samjacoby/touchsynth/README.md

# Touch Synth
32U4-based Arduino (Leonardo) compatible synthesizer board

In effect, "forked" from bdm.cc
