samjacoby/touchsynth/board/touchsynth.brd

## EAGLE design board/touchsynth.brd (2013-03-25)

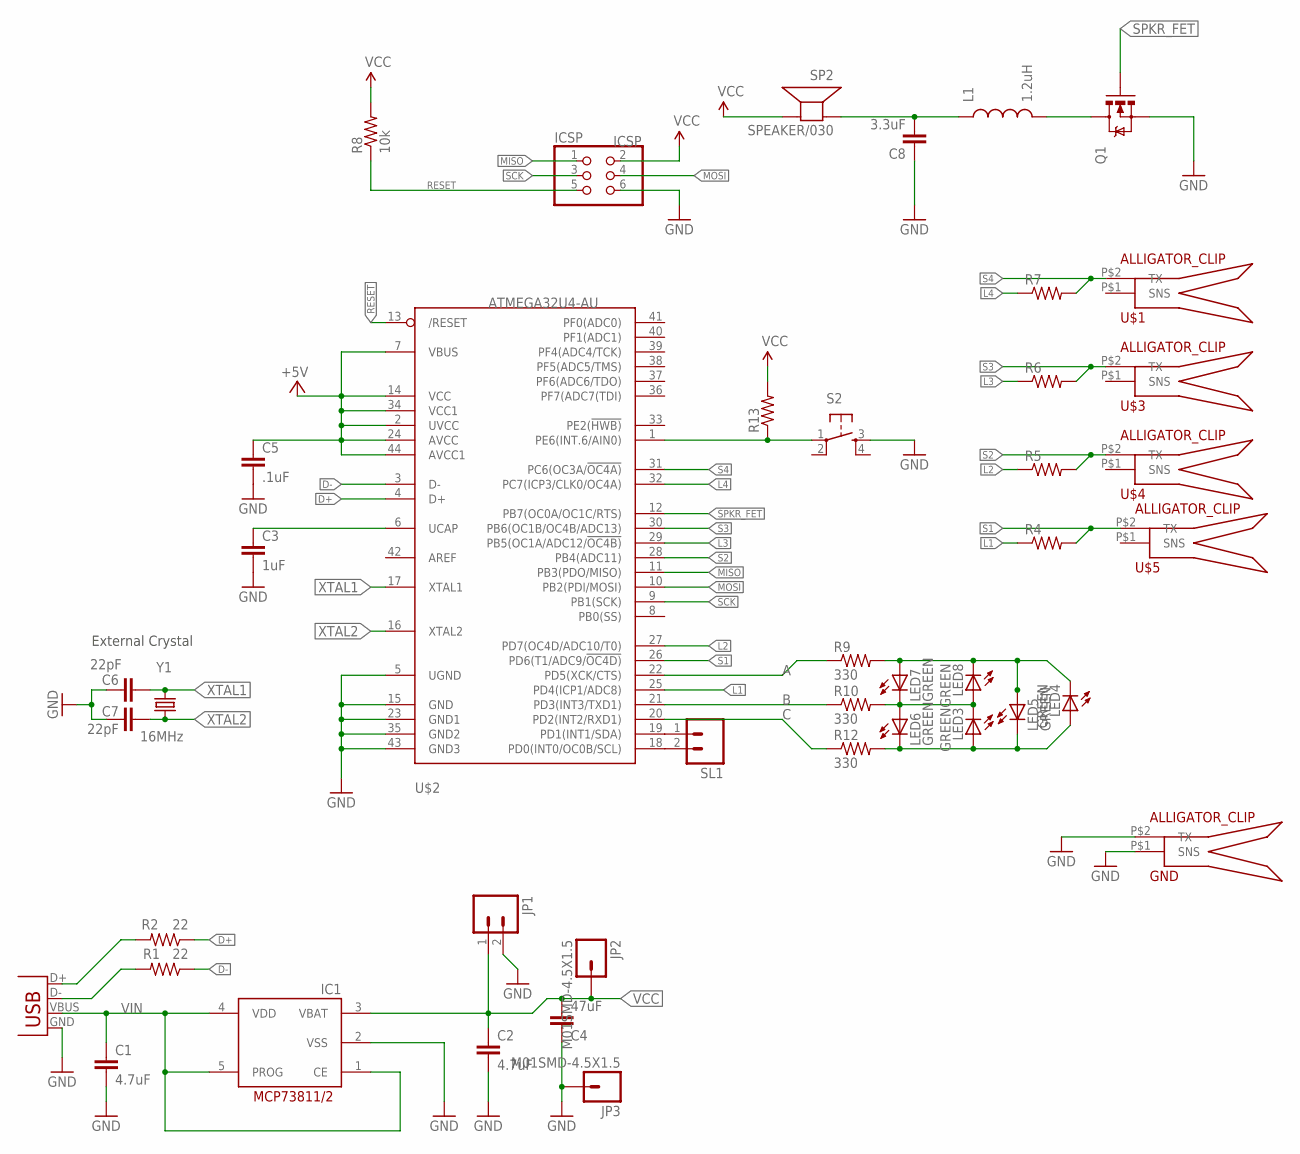
[picture p1: schematic touchsynth.sch]

Parts:
C1, C2: 4.7uF; 0603-CAP
C3: 1uF; 0603-CAP
C4: 47uF; 1206
C5: .1uF; 0603-CAP
C6, C7: 22pF; 0402-CAP
C8: 3.3uF; 0603-CAP
GND: ALLIGATOR_CLIP
IC1: MCP73811/2; SOT23-5L
ICSP: ICSP; 2X03
JP1: M02PTH; 1X02
JP2, JP3: M01SMD-4.5X1.5; PAD-1.5X4.5
L1: 1.2uH; 1210
LED3, LED4, LED5, LED6, LED7, LED8: GREEN; LED-1206-BOTTOM
Q1: MOSFET-NCHANNELSMD; SOT23-3
R1, R2: 22; 0402-RES
R4, R5, R6, R7, R13: RESISTOR0603-RES; 0603-RES
R8: 10k; 0603-RES
R9, R10, R12: 330; 0603-RES
S2: TAC_SWITCHSMD; TACTILE_SWITCH_SMD
SL1: M02; 02P
SP2: SPEAKER/030; AST-030
U$1, U$3, U$4, U$5: ALLIGATOR_CLIP
U$2: ATMEGA32U4-AU; TQFP44-THIN
X1: USB; USB-MINIB-NOSTOP-THIN
Y1: 16MHz; CRYSTAL-SMD-5X3

Connections:
A: R9.1, U$2.22 (PD5(XCK/CTS))
B: R10.1, U$2.21 (PD3(INT3/TXD1))
C: R12.1, U$2.20 (PD2(INT2/RXD1))
D+: R2.1, U$2.4 (D+)
D-: R1.1, U$2.3 (D-)
GND: C1.2, C2.2, C3.2, C4.1, C5.2, C6.2, C7.2, C8.1, GND.P$1 (SNS), GND.P$2 (TX), IC1.2 (VSS), ICSP.6, JP1.2, JP3.P$1, Q1.2 (S), S2.3, U$2.5 (UGND), U$2.15 (GND), U$2.23 (GND1), U$2.35 (GND2), U$2.43 (GND3), X1.GND
L1: R4.1, U$2.25 (PD4(ICP1/ADC8))
L2: R5.1, U$2.27 (PD7(OC4D/ADC10/T0))
L3: R6.1, U$2.29 (PB5(OC1A/ADC12/!OC4B))
L4: R7.1, U$2.32 (PC7(ICP3/CLK0/OC4A))
MISO: ICSP.1, U$2.11 (PB3(PDO/MISO))
MOSI: ICSP.4, U$2.10 (PB2(PDI/MOSI))
unnamed: C3.1, U$2.6 (UCAP)
unnamed: C8.2, L1.1, SP2.1 (+)
unnamed: SL1.1, U$2.19 (PD1(INT1/SDA))
unnamed: R13.1, S2.1, U$2.1 (PE6(INT.6/AIN0))
unnamed: LED3.C, LED6.A, LED7.C, LED8.A, R10.2
unnamed: R1.2, X1.D-
unnamed: SL1.2, U$2.18 (PD0(INT0/OC0B/SCL))
unnamed: R2.2, X1.D+
unnamed: LED4.C, LED5.A, LED7.A, LED8.C, R9.2
unnamed: LED3.A, LED4.A, LED5.C, LED6.C, R12.2
unnamed: L1.2, Q1.3 (D)
RESET: ICSP.5, R8.1, U$2.13 (/RESET)
S1: R4.2, U$2.26 (PD6(T1/ADC9/!OC4D)), U$5.P$2 (TX)
S2: R5.2, U$2.28 (PB4(ADC11)), U$4.P$2 (TX)
S3: R6.2, U$2.30 (PB6(OC1B/OC4B/ADC13)), U$3.P$2 (TX)
S4: R7.2, U$1.P$2 (TX), U$2.31 (PC6(OC3A/!OC4A))
SCK: ICSP.3, U$2.9 (PB1(SCK))
SPKR_FET: Q1.1 (G), U$2.12 (PB7(OC0A/OC1C/RTS))
VCC: C2.1, C4.2, C5.1, IC1.3 (VBAT), ICSP.2, JP1.1, JP2.P$1, R8.2, R13.2, SP2.2 (-), U$2.2 (UVCC), U$2.7 (VBUS), U$2.14 (VCC), U$2.24 (AVCC), U$2.34 (VCC1), U$2.44 (AVCC1)
VIN: C1.1, IC1.1 (CE), IC1.4 (VDD), IC1.5 (PROG), X1.VBUS
XTAL1: C6.1, U$2.17 (XTAL1), Y1.3 (2)
XTAL2: C7.1, U$2.16 (XTAL2), Y1.1

Notes on the sheet:
External Crystal

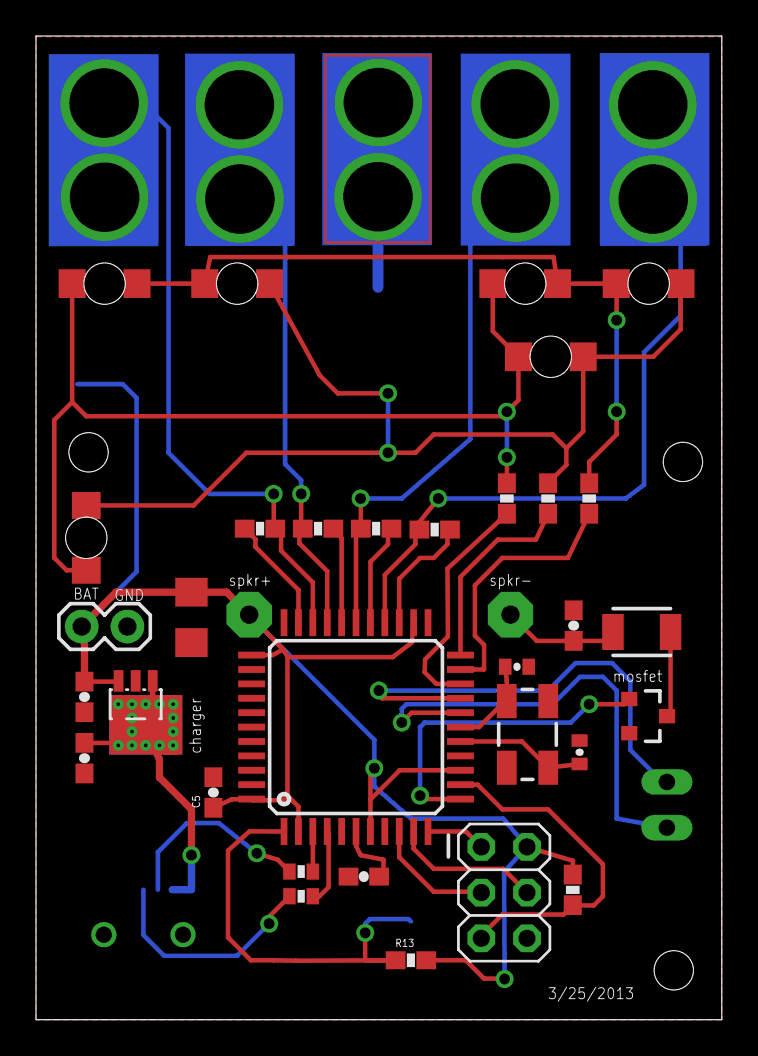
[picture p2: board touchsynth.brd from above]

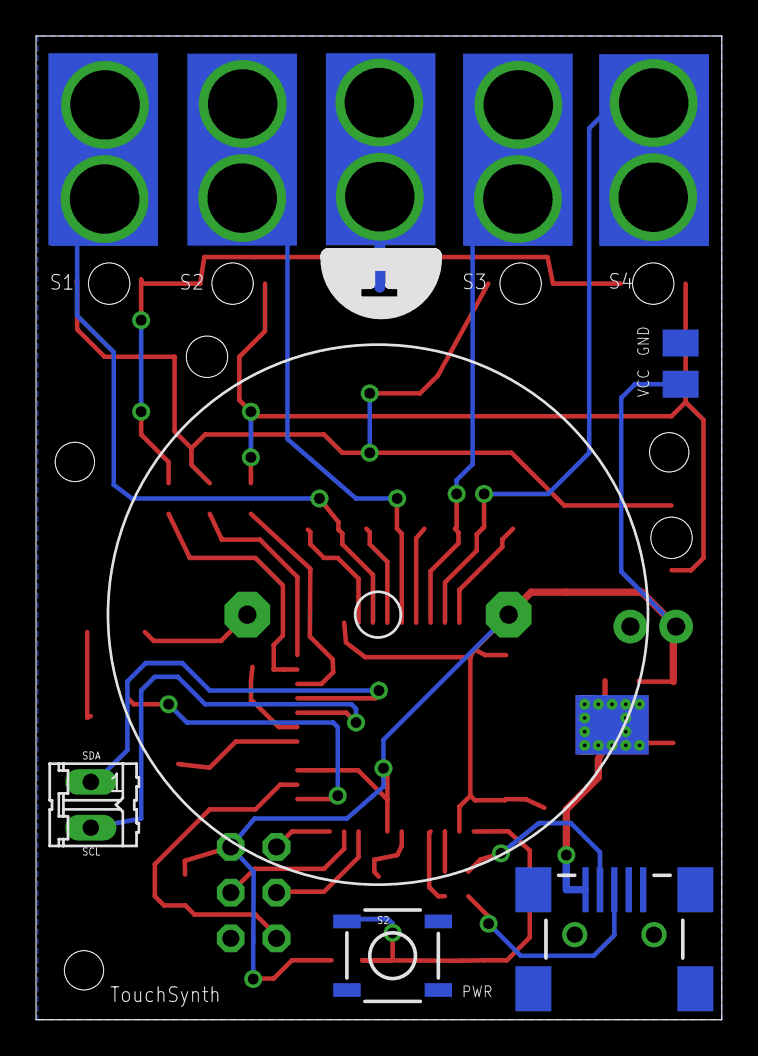
[picture p3: board touchsynth.brd from below]

Board: 2 copper layers, 38.1 x 54.7 mm, 43 parts (10 on the bottom side), 34 nets.
