samjacoby/touchsynth/(commit log)

2013-01-21 Changed to cpp to resolve linking issues.
    [audio.cpp]
2013-01-21 track this.
2013-01-22 This is looking good. Timer1 & Timer3 running.
2013-01-22 Working with capacitive sensor.
2013-01-24 Keep track of certain things, as the master does.
2013-01-24 Sensor stuff should go in sense.c & sense.h
2013-03-20 Starting to add button functionality.
2013-03-22 Adding LED files.
2013-03-23 Working sound, Working LEDs.
2013-03-24 Working button.
2013-03-25 Keep track of the boards in here.
    [touchsynth.brd, touchsynth.sch]
2013-04-11 Fixing LEDs.
